FigerPrintLab/AmpModule/README.md

# AmpModule (Stakx)

Hardware implementation for the Stakx amplifier's front panel PCB.
