FigerPrintLab/AmpModule/schemes/note.md

# Amplificatore

1 IN --> 2 OUT  
Powersof Litemod 4HC amp module 222€  
Powersoft DSP 102€  
IN -> DSP -> PCB -> AMP -> OUT

## PCB

- User interface
- -10/+10 dB TRIM (RS25) noisless
- Mute push buttons (latch) noisless
