FigerPrintLab/AmpModule/Logic scheme.png

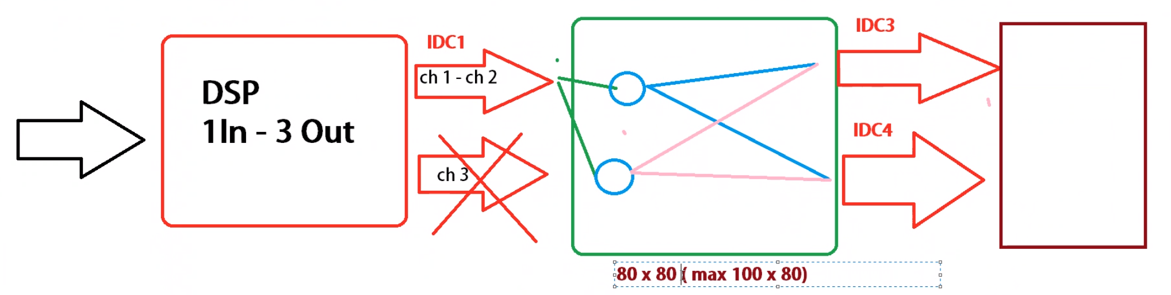
Logic scheme.png
