FigerPrintLab/AmpModule/KiCad/PCB_model.FCStd

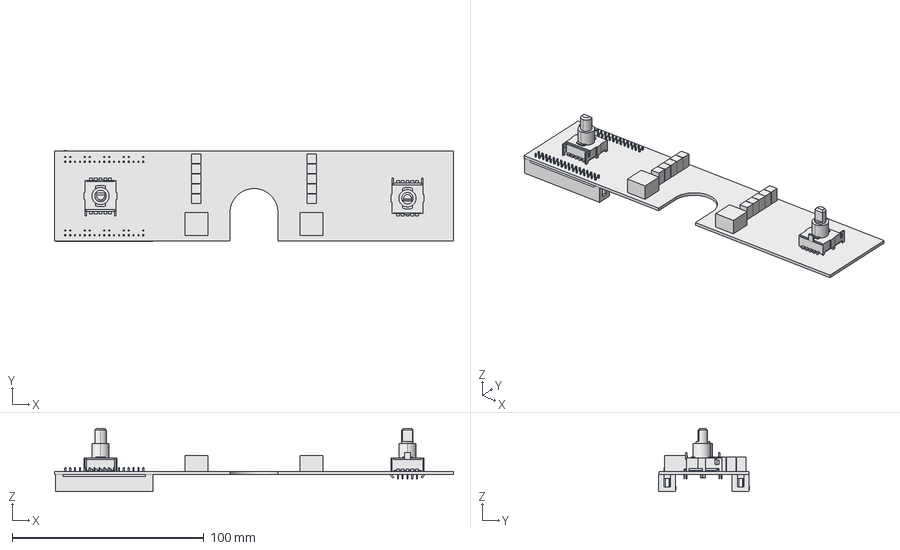
[picture p2: CAD file, 2021-10-24]
KiCad/PCB_model.FCStd
208.0 x 47.2 x 33.1 mm
