FigerPrintLab/AmpModule/KiCad/Amp Module.kicad_pcb

## KiCad design KiCad/Amp Module.kicad_pcb (2021-10-24)

Schematic: Amp Module.sch, AmpModule front panel (2way)

Parts:
C1, C2: 22p; C_0805_2012Metric
C3, C4, C5, C6, C11, C12, C13, C14: 0.1uF; C_0805_2012Metric
C7: 10uF; CP_Elec_4x5.3
C8: 22uF; CP_Elec_4x5.3
C9, C10: 1u; C_0805_2012Metric
D1, D2: D_Small; D_MiniMELF
D3: READY1; LED_Rectangular_W5.0mm_H5.0mm
D4: READY2; LED_Rectangular_W5.0mm_H5.0mm
D5: ON; LED_Rectangular_W5.0mm_H5.0mm
J1: DSP; IDC-Header_2x17_P2.54mm_Vertical
J2: LITEMOD; IDC-Header_2x17_P2.54mm_Vertical
R1, R2: 8.2k; R_0805_2012Metric
R3, R4, R11, R17: 2.7k; R_0805_2012Metric
R5, R6, R13, R19: 1k; R_0805_2012Metric
R7, R8, R12, R18: 1.8k; R_0805_2012Metric
R9, R15: 5.6k; R_0805_2012Metric
R10, R16: 3.9k; R_0805_2012Metric
R14, R20: 470; R_0805_2012Metric
R21, R22, R27, R28, R29: 180; R_0805_2012Metric
R23, R24: 51k; R_0805_2012Metric
R25, R26: 22k; R_0805_2012Metric
SW1, SW2: Alps_SRBV170701
SW3: MUTE1; TL2-NNS7
SW4: MUTE2; TL2-NNS7
U1, U2: NE5532; SOIC-8_3.9x4.9mm_P1.27mm
U3: AMS1117-5.0; SOT-223-3_TabPin2
U4: TL072; SOIC-8_3.9x4.9mm_P1.27mm
U5: 74LVC2G14; SOT-23-6
U6: 74VHC74; TSSOP-14_4.4x5mm_P0.65mm
U7: 74HC08; SOIC-14_3.9x8.7mm_P1.27mm

Connections:
+5VDC: J1.4, J1.31, J2.4, J2.31
+5V_REG: C8.1, C11.2, C12.2, C13.2, C14.2, D5.2 (A), R21.1, R22.1, R23.1, R24.1, U3.2 (VO), U4.8 (V+), U5.5 (VCC), U6.1 (~R), U6.4 (~S), U6.10 (~S), U6.13 (~R), U6.14 (VCC), U7.14 (VCC); also elsewhere on the board
+12VDC: C5.1, C6.1, C7.1, J1.13, J1.22, J2.13, J2.22, U1.8 (V+), U2.8 (V+), U3.3 (VI)
+VCCMON: J1.16, J1.19, J2.16, J2.19
-12VDC: C3.1, C4.1, J1.14, J1.21, J2.14, J2.21, U1.4 (V-), U2.4 (V-)
-VCCMON: J1.17, J1.18, J2.17, J2.18
DSP_MUTE1: J1.15, U7.2
DSP_MUTE2: J1.20, U7.4
DSP_OUT1+: J1.6, R1.1
DSP_OUT1-: J1.7
DSP_OUT2+: J1.29, R2.1
DSP_OUT2-: J1.28
GND: C3.2, C4.2, C5.2, C6.2, C7.2, C8.2, C9.2, C10.2, C11.1, C12.1, C13.1, C14.1, J1.5, J1.8, J1.27, J1.30, J2.5, J2.8, J2.27, J2.30, R3.2, R4.2, R7.1, R8.1, R27.2, R28.2, R29.2, SW3.1, SW4.1, U3.1 (GND), U4.4 (V-), U5.2 (GND), U6.7 (GND), U7.7 (GND); also elsewhere on the board
IOUT1MON: J1.11, J2.11
IOUT2MON: J1.24, J2.24
LM_IN1+: J2.6, U1.6 (-), U1.7
LM_IN1-: J2.7
LM_IN2+: J2.29, U2.6 (-), U2.7
LM_IN2-: J2.28
LM_MUTE1: J2.15, SW3.3 (K), U7.3
LM_MUTE2: J2.20, SW4.3 (K), U7.6
unnamed: C1.1, SW1.1, SW1.10, U1.1, U1.5 (+)
unnamed: C1.2, R7.2, R9.1, R10.1, R11.1, R12.1, R13.1, R14.1, SW1.8, U1.2 (-)
unnamed: C2.1, SW2.1, SW2.10, U2.1, U2.5 (+)
unnamed: C2.2, R8.2, R15.1, R16.1, R17.1, R18.1, R19.1, R20.1, SW2.8, U2.2 (-)
unnamed: C9.1, D1.1 (K), R25.1, U5.1
unnamed: C10.1, D2.1 (K), R26.1, U5.3
unnamed: D1.2 (A), R23.2, R25.2, SW3.2
unnamed: D2.2 (A), R24.2, R26.2, SW4.2
unnamed: D3.1 (K), R27.1
unnamed: D4.1 (K), R28.1
unnamed: D5.1 (K), R29.1
unnamed: R1.2, R3.1, R5.2
unnamed: R2.2, R4.1, R6.2
unnamed: R5.1, U1.3 (+)
unnamed: R6.1, U2.3 (+)
unnamed: R9.2, SW1.2
unnamed: R10.2, SW1.3
unnamed: R11.2, SW1.4
unnamed: R12.2, SW1.5
unnamed: R13.2, SW1.6
unnamed: R14.2, SW1.7
unnamed: R15.2, SW2.2
unnamed: R16.2, SW2.3
unnamed: R17.2, SW2.4
unnamed: R18.2, SW2.5
unnamed: R19.2, SW2.6
unnamed: R20.2, SW2.7
unnamed: R21.2, SW3.4 (A)
unnamed: R22.2, SW4.4 (A)
unnamed: U5.4, U6.11 (C)
unnamed: U5.6, U6.3 (C)
unnamed: U6.2 (D), U6.6 (~Q)
unnamed: U6.5 (Q), U7.1
unnamed: U6.9 (Q), U7.5
unnamed: U6.8 (~Q), U6.12 (D)
PROTECT1: J1.10, J2.10; also elsewhere on the board
PROTECT2: J1.25, J2.25; also elsewhere on the board
READY1: J2.2, U4.3 (+)
READY2: J2.33, U4.5 (+)
READY_DSP1: D3.2 (A), J1.2, U4.1, U4.2 (-)
READY_DSP2: D4.2 (A), J1.33, U4.6 (-), U4.7
RESERVED_A: J1.3, J2.3
RESERVED_B: J1.32, J2.32
SDPWS: J1.1, J1.34, J2.1, J2.34
TEMPMON12: J1.12, J1.23, J2.12, J2.23; also elsewhere on the board
VOUT1MON: J1.9, J2.9; also elsewhere on the board
VOUT2MON: J1.26, J2.26; also elsewhere on the board

Notes on the sheet:
IDC
MUTE
AUDIO
STATUS LEDs
REGULATOR
check cap

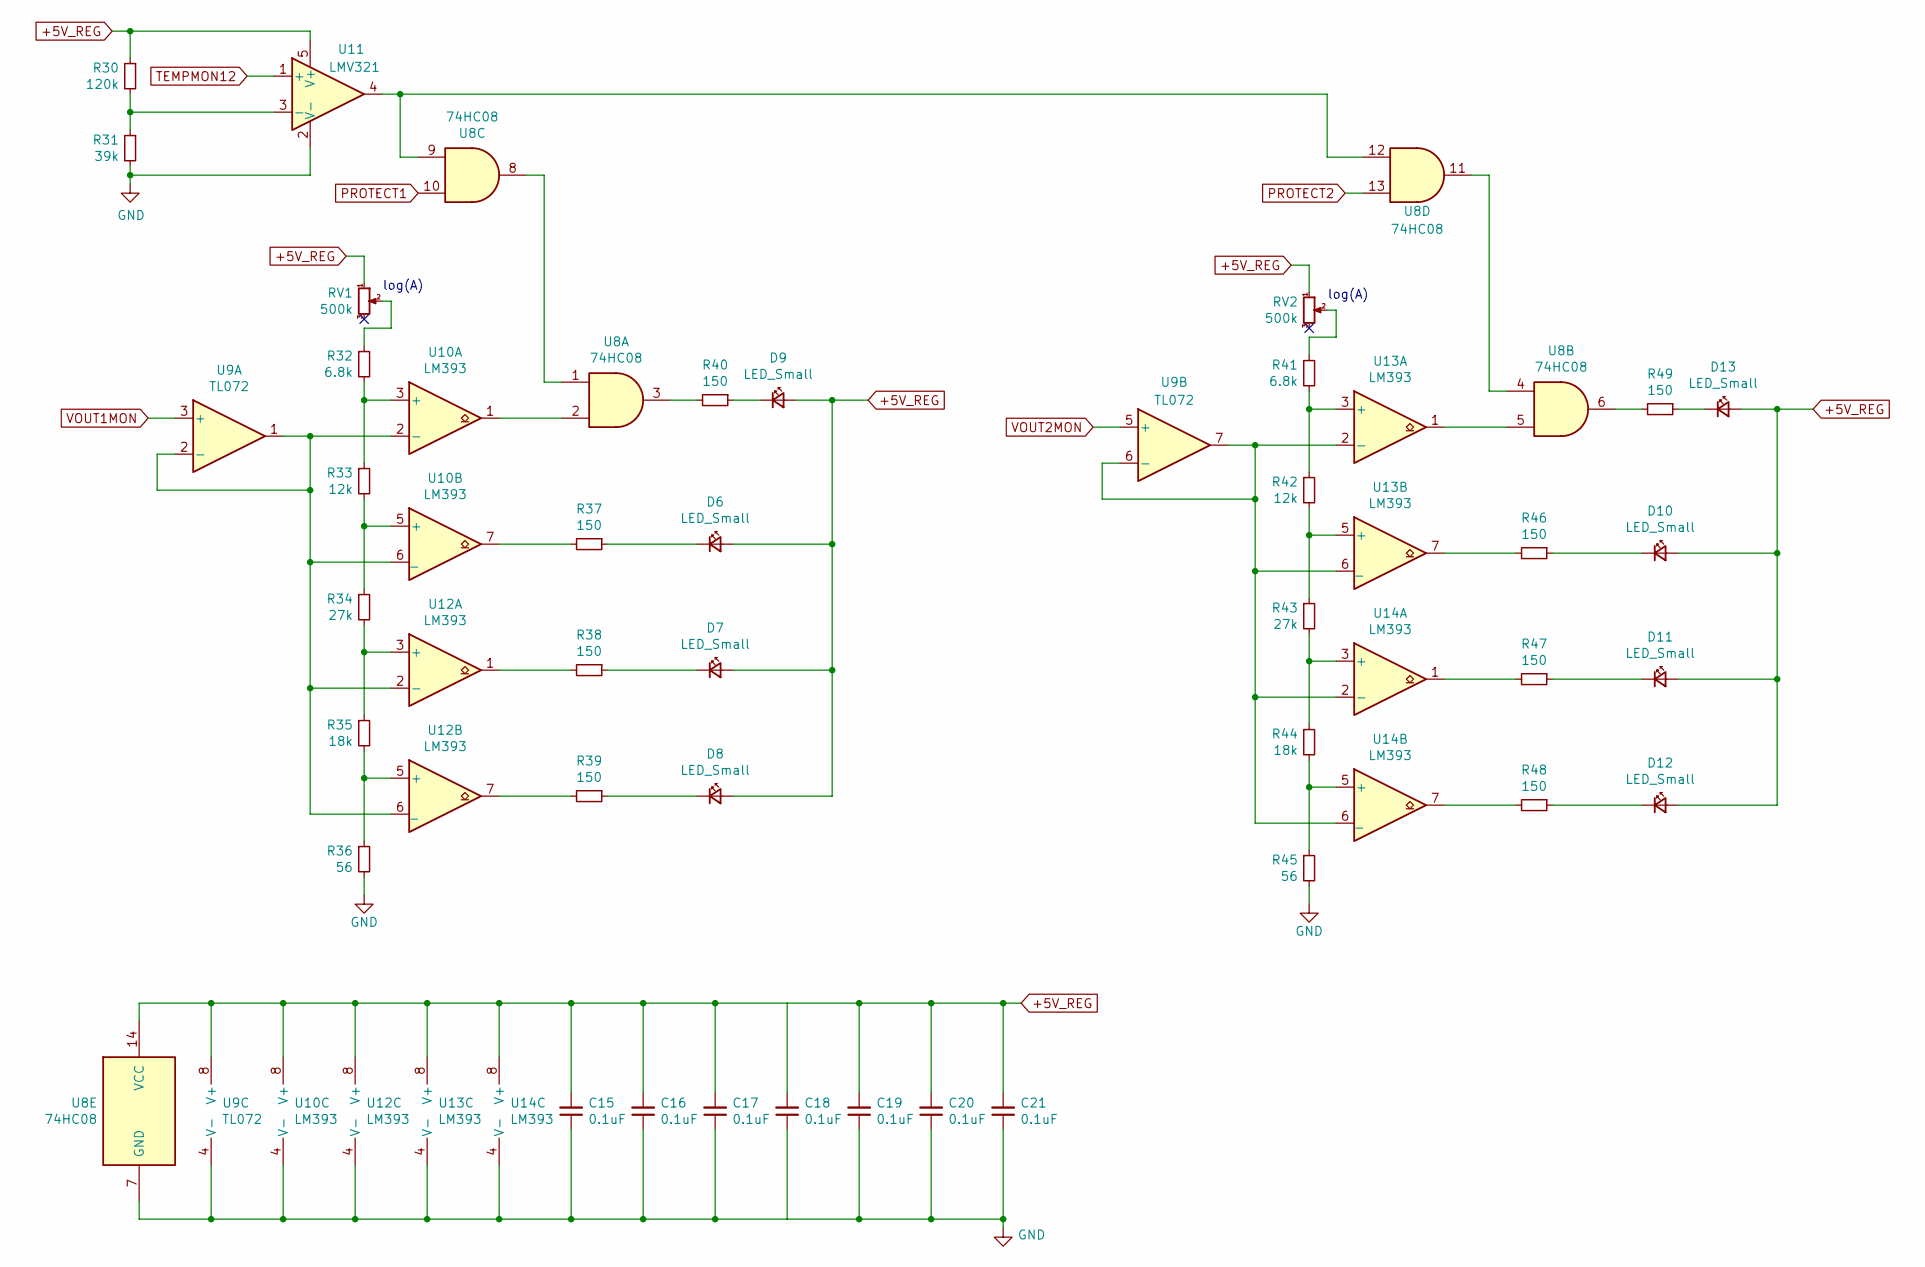
[picture p3: schematic vu_meter.sch]

Parts:
C15, C16, C17, C18, C19, C20, C21: 0.1uF; C_0805_2012Metric
D6, D7, D8, D9, D10, D11, D12, D13: LED_Small; LED_Rectangular_W5.0mm_H5.0mm
R30: 120k; R_0805_2012Metric
R31: 39k; R_0805_2012Metric
R32, R41: 6.8k; R_0805_2012Metric
R33, R42: 12k; R_0805_2012Metric
R34, R43: 27k; R_0805_2012Metric
R35, R44: 18k; R_0805_2012Metric
R36, R45: 56; R_0805_2012Metric
R37, R38, R39, R40, R46, R47, R48, R49: 150; R_0805_2012Metric
RV1, RV2: 500k; Trim_audio
U8: 74HC08; SOIC-14_3.9x8.7mm_P1.27mm
U9: TL072; SOIC-8_3.9x4.9mm_P1.27mm
U10, U12, U13, U14: LM393; SOIC-8_3.9x4.9mm_P1.27mm
U11: LMV321; SOT-23-5

Connections:
+5V_REG: C15.2, C16.2, C17.2, C18.2, C19.2, C20.2, C21.2, D6.2 (A), D7.2 (A), D8.2 (A), D9.2 (A), D10.2 (A), D11.2 (A), D12.2 (A), D13.2 (A), R30.1, RV1.1, RV2.1, U8.14 (VCC), U9.8 (V+), U10.8 (V+), U11.5 (V+), U12.8 (V+), U13.8 (V+), U14.8 (V+); also elsewhere on the board
GND: C15.1, C16.1, C17.1, C18.1, C19.1, C20.1, C21.1, R31.2, R36.2, R45.2, U8.7 (GND), U9.4 (V-), U10.4 (V-), U11.2 (V-), U12.4 (V-), U13.4 (V-), U14.4 (V-); also elsewhere on the board
unnamed: D6.1 (K), R37.1
unnamed: D7.1 (K), R38.1
unnamed: D8.1 (K), R39.1
unnamed: D9.1 (K), R40.1
unnamed: D10.1 (K), R46.1
unnamed: D11.1 (K), R47.1
unnamed: D12.1 (K), R48.1
unnamed: D13.1 (K), R49.1
unnamed: R30.2, R31.1, U11.3 (-)
unnamed: R32.1, RV1.2
unnamed: R32.2, R33.1, U10.3 (+)
unnamed: R33.2, R34.1, U10.5 (+)
unnamed: R34.2, R35.1, U12.3 (+)
unnamed: R35.2, R36.1, U12.5 (+)
unnamed: R37.2, U10.7
unnamed: R38.2, U12.1
unnamed: R39.2, U12.7
unnamed: R40.2, U8.3
unnamed: R41.1, RV2.2
unnamed: R41.2, R42.1, U13.3 (+)
unnamed: R42.2, R43.1, U13.5 (+)
unnamed: R43.2, R44.1, U14.3 (+)
unnamed: R44.2, R45.1, U14.5 (+)
unnamed: R46.2, U13.7
unnamed: R47.2, U14.1
unnamed: R48.2, U14.7
unnamed: R49.2, U8.6
unnamed: U8.1, U8.8
unnamed: U8.4, U8.11
unnamed: U8.2, U10.1
unnamed: U9.1, U9.2 (-), U10.2 (-), U10.6 (_), U12.2 (-), U12.6 (_)
unnamed: U8.9, U8.12, U11.4
unnamed: U8.5, U13.1
unnamed: U9.6 (-), U9.7, U13.2 (-), U13.6 (_), U14.2 (-), U14.6 (_)
PROTECT1: U8.10; also elsewhere on the board
PROTECT2: U8.13; also elsewhere on the board
TEMPMON12: U11.1 (+); also elsewhere on the board
VOUT1MON: U9.3 (+); also elsewhere on the board
VOUT2MON: U9.5 (+); also elsewhere on the board

Notes on the sheet:
log(A)

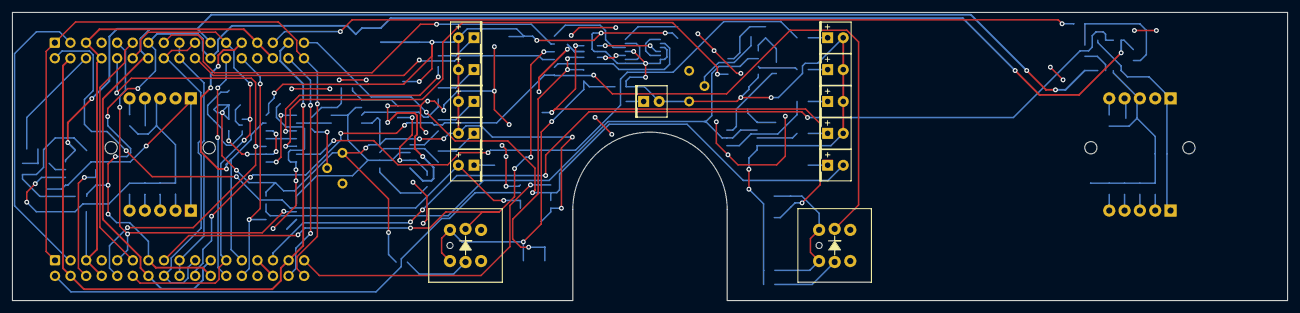
[picture p4: board Amp Module.kicad_pcb from above]

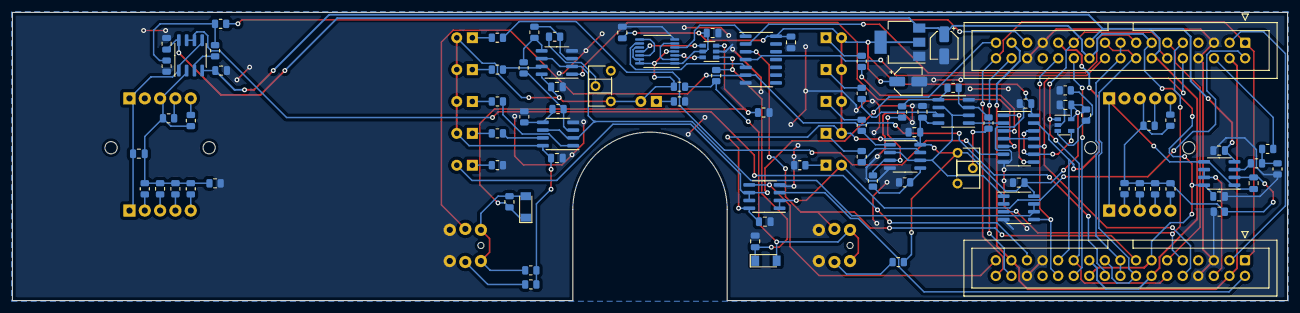
[picture p5: board Amp Module.kicad_pcb from below]

Board: 2 copper layers, 208.0 x 47.0 mm, 105 parts (90 on the bottom side), 98 nets.
