FigerPrintLab/AmpModule/(commit log)

2020-12-03 update KiCad folder
    [Amp Module.kicad_pcb, Amp Module.sch]
2020-12-05 Update schematics
    [Amp Module.sch]
2020-12-06 Update schematic
    [Amp Module.sch]
2020-12-18 schematic updated
    [Amp Module.sch]
2020-12-19 updated schematic
    [Amp Module.sch, Unused.sch]
2021-01-06 figerprint icon
    [Amp Module.kicad_pcb]
2021-02-28 added flow chart
2021-02-28 first 2way commit
    [Amp Module.sch]
2021-02-28 added basic filter and trim
    [Amp Module.sch, Unused.sch, filter.sch, trim.sch]
2021-03-01 restored filter and added initial attenuation in trim
    [Amp Module.sch, Unused.sch, VU_Meter.sch, control.sch, filter.sch, trim.sch]
2021-03-02 changed Q to a fixed value
    [Amp Module.sch, VU_Meter.sch, filter.sch, trim.sch]
2021-03-03 moved initial attenuation to filter input
    [filter.sch, trim.sch]
2021-03-06 saved from laptop and added new questions
    [VU_Meter.sch, control.sch, trim.sch]
2021-03-16 updated schematic to latest KiCad version
    [Amp Module.sch, Unused.sch]
2021-03-18 removed VU Meter sheet
    [Amp Module.sch, VU_Meter.sch, control.sch, filter.sch, latch.sch, trim.sch]
2021-03-20 changed 4053 to DG419 & added negative latch
    [Amp Module.sch, control.sch, filter.sch, l_neg.sch, latch.sch, latch_neg.sch, trim.sch]
2021-04-30 added custom VU meter
    [Amp Module.sch, VU_Meter.sch, control.sch, l_neg.sch]
2021-04-30 first single IDC commit
    [Amp Module.sch, Unused.sch, VU_Meter.sch, control.sch, filter.sch, l_neg.sch, latch.sch, latch_neg.sch]
2021-08-11 linux friendly filenames
    [vu_meter.sch]
2021-09-16 freeze at 3 leds
    [Amp Module.sch, l_neg.sch, vu_meter.sch]
2021-09-25 schematic completed
    [Amp Module.sch, l_neg.sch, vu_meter.sch]
2021-09-28 edited chez Gabri's
    [Amp Module.sch, l_neg.sch, vu_meter.sch]
2021-09-28 added bom
    [l_neg.sch, vu_meter.sch]
2021-10-20 finished PCB with TL12
    [Amp Module.kicad_pcb, Amp Module.sch, PCB_model.FCStd, vu_meter.sch]
2021-10-20 changed to TL2
    [Amp Module.kicad_pcb, Amp Module.sch]
2021-10-23 corrected rotary switch footprint
    [Amp Module.kicad_pcb, Amp Module.sch]
2021-10-23 started BOM export
    [Amp Module.kicad_pcb, Amp Module.sch, vu_meter.sch]
2021-10-24 exported BOM and pos
    [Amp Module.csv, Amp Module.kicad_pcb, Amp Module.ods, Amp Module.sch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]
2021-10-24 preparing merge from 2ohms
    [Amp Module.kicad_pcb, Amp Module.sch, Unused.sch]
